jfrabosi/RadarWork/box_mount.SLDPRT

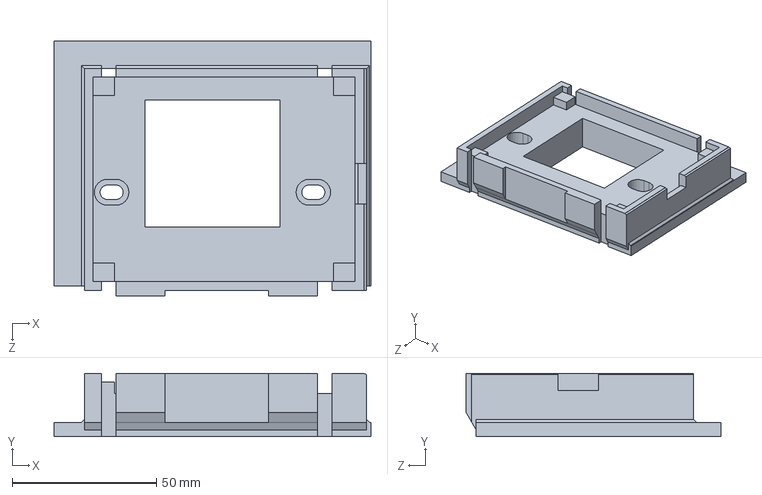
[picture p1: CAD file, 2024-11-15]
box_mount.SLDPRT
110.0 x 22.0 x 88.5 mm
