jfrabosi/RadarWork/QTY1_radar_mount_B.STL

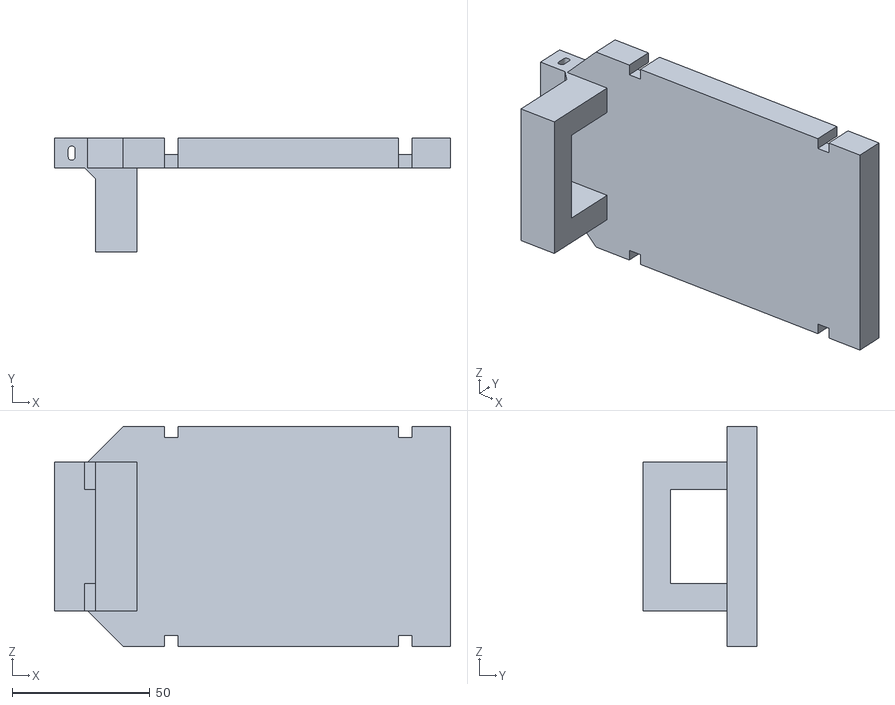
[picture p2: CAD file, 2024-10-24]
QTY1_radar_mount_B.STL
144.0 x 41.5 x 80.0
