jfrabosi/RadarWork/stick_mount.SLDPRT

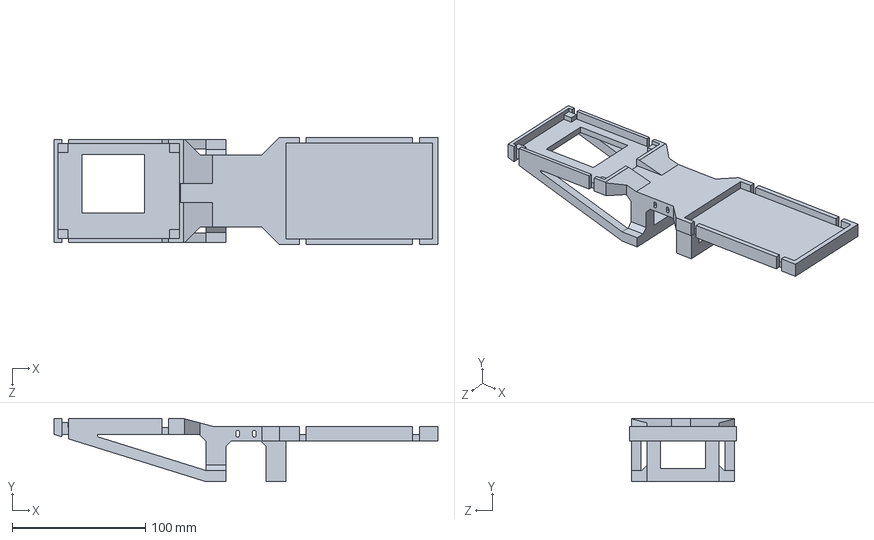
[picture p3: CAD file, 2024-10-24]
stick_mount.SLDPRT
288.0 x 47.5 x 80.0 mm
