jfrabosi/RadarWork/QTY1_radar_mount_A.STL

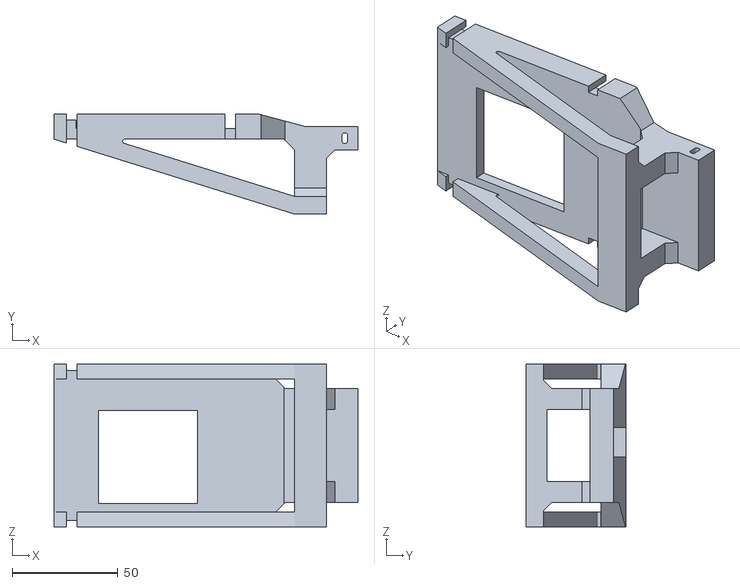
[picture p4: CAD file, 2024-10-24]
QTY1_radar_mount_A.STL
144.0 x 47.5 x 77.0
