jfrabosi/RadarWork/testing_pics/Bathtub/tub_draining.png

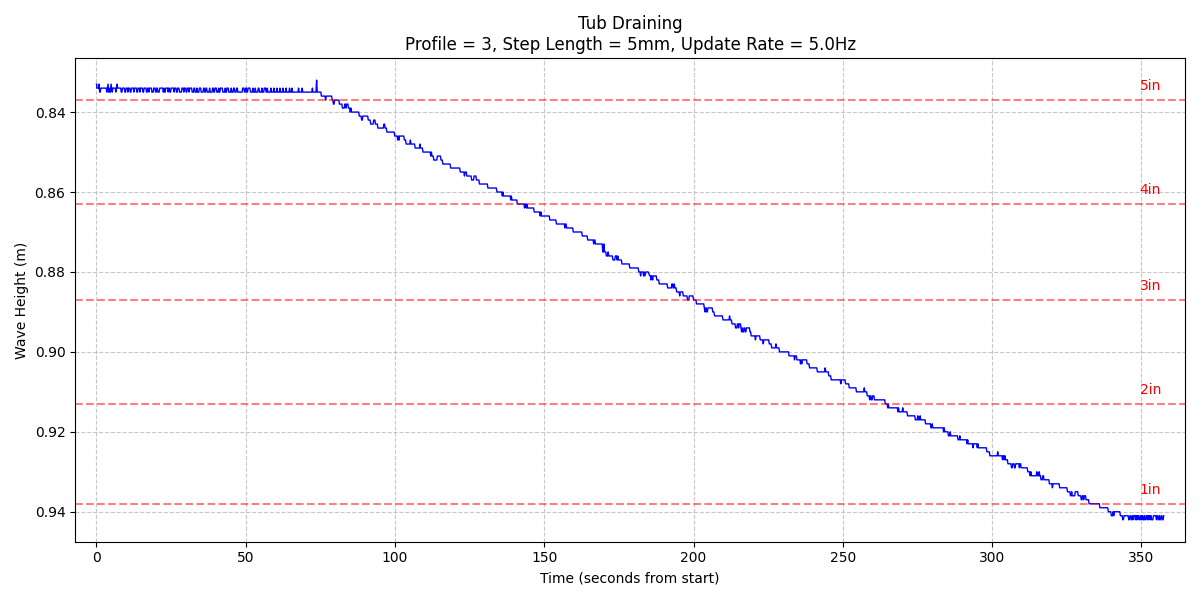
testing_pics/Bathtub/tub_draining.png
