jfrabosi/RadarWork/testing_pics/Bathtub/tub_filling.png

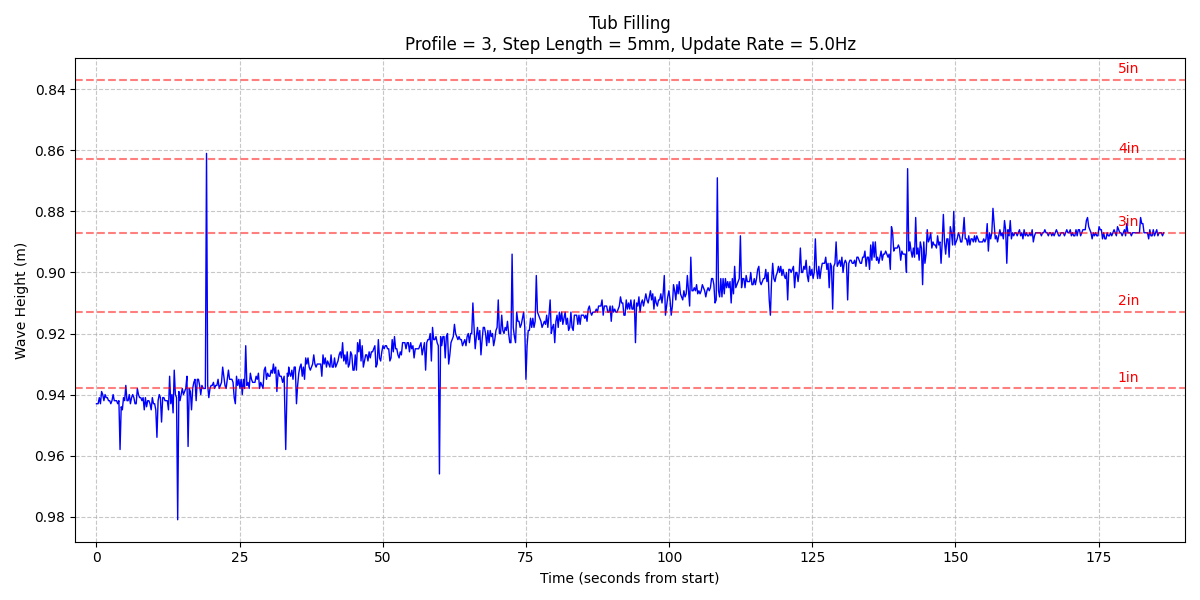
testing_pics/Bathtub/tub_filling.png
