jfrabosi/RadarWork/testing_pics/Fo-SHIP/20hz.png

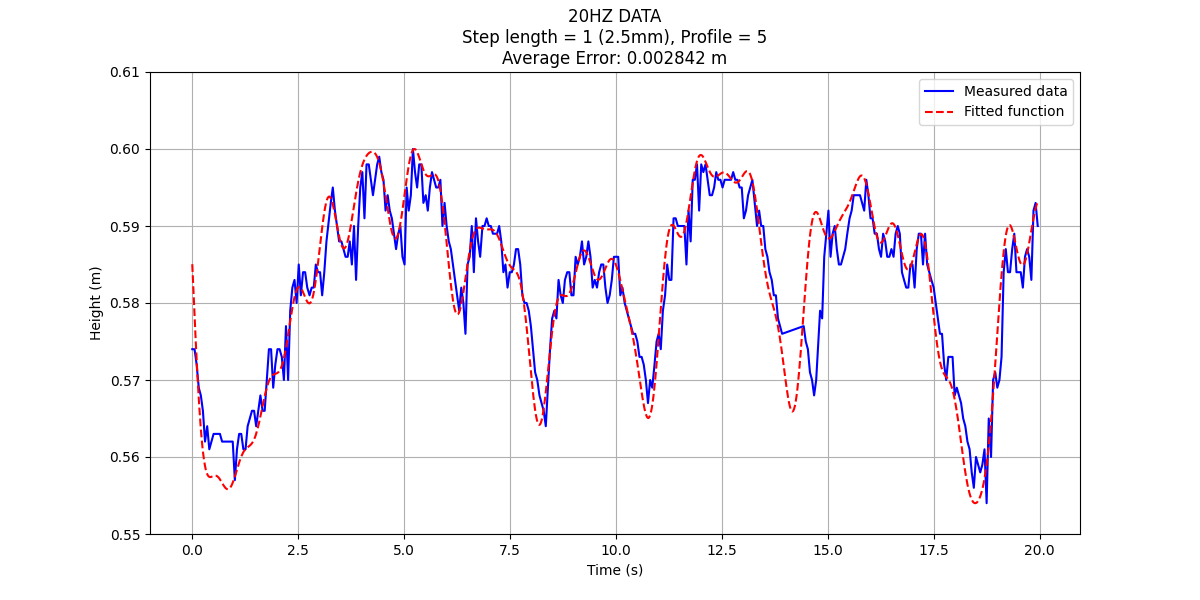
testing_pics/Fo-SHIP/20hz.png
