jfrabosi/RadarWork/testing_pics/Fo-SHIP/l1p1.png

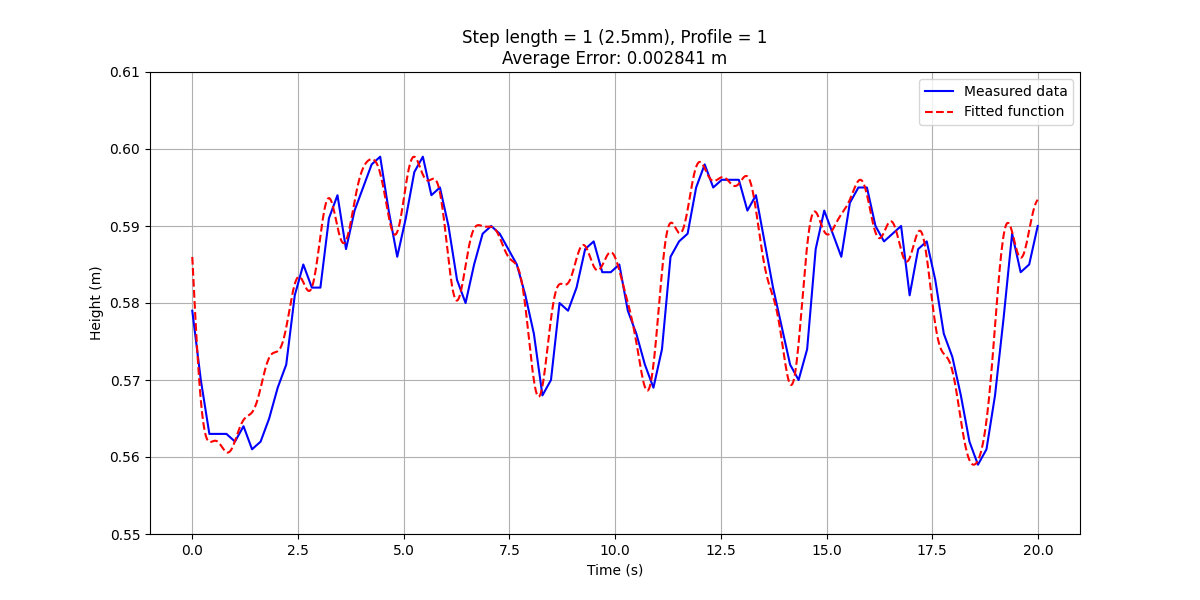
testing_pics/Fo-SHIP/l1p1.png
