jfrabosi/RadarWork/testing_pics/Fo-SHIP/l1p2.png

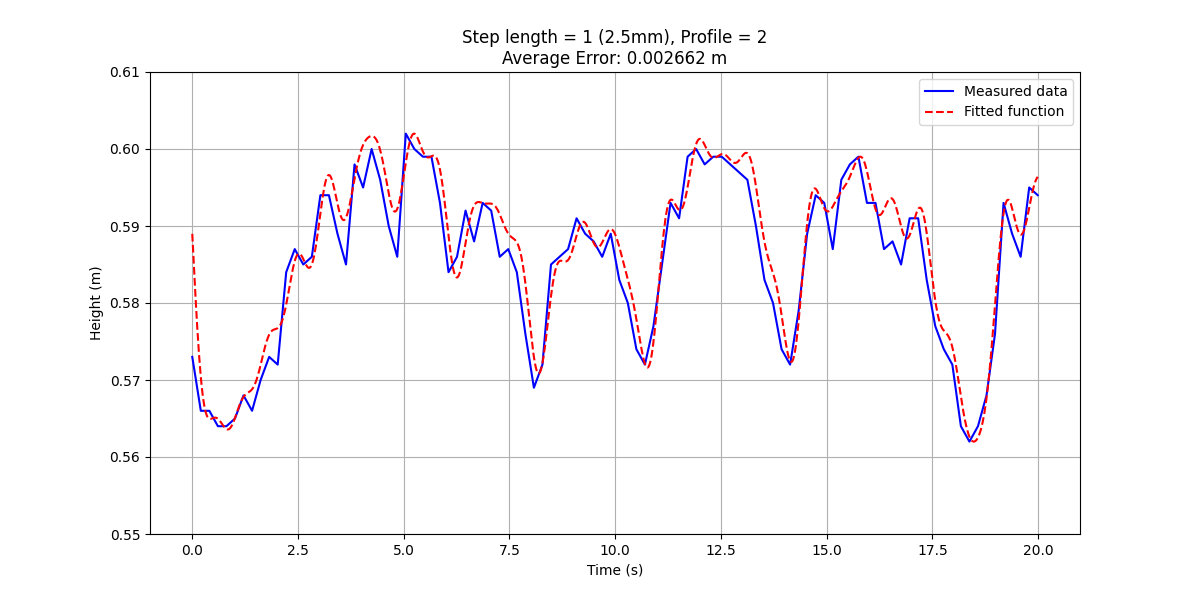
testing_pics/Fo-SHIP/l1p2.png
