jfrabosi/RadarWork/testing_pics/mbari_first_look.png

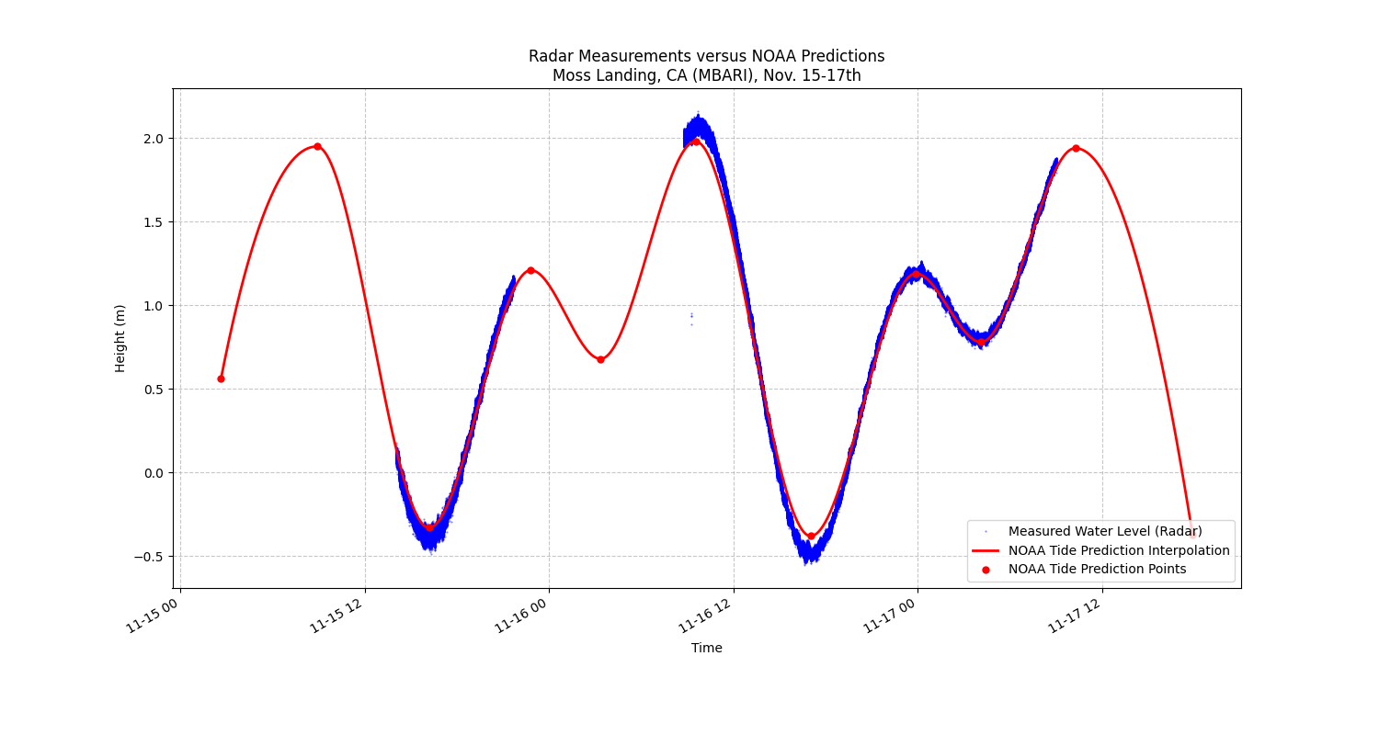
testing_pics/mbari_first_look.png
