jfrabosi/RadarWork/testing_pics/mbari_first_look_closeup.png

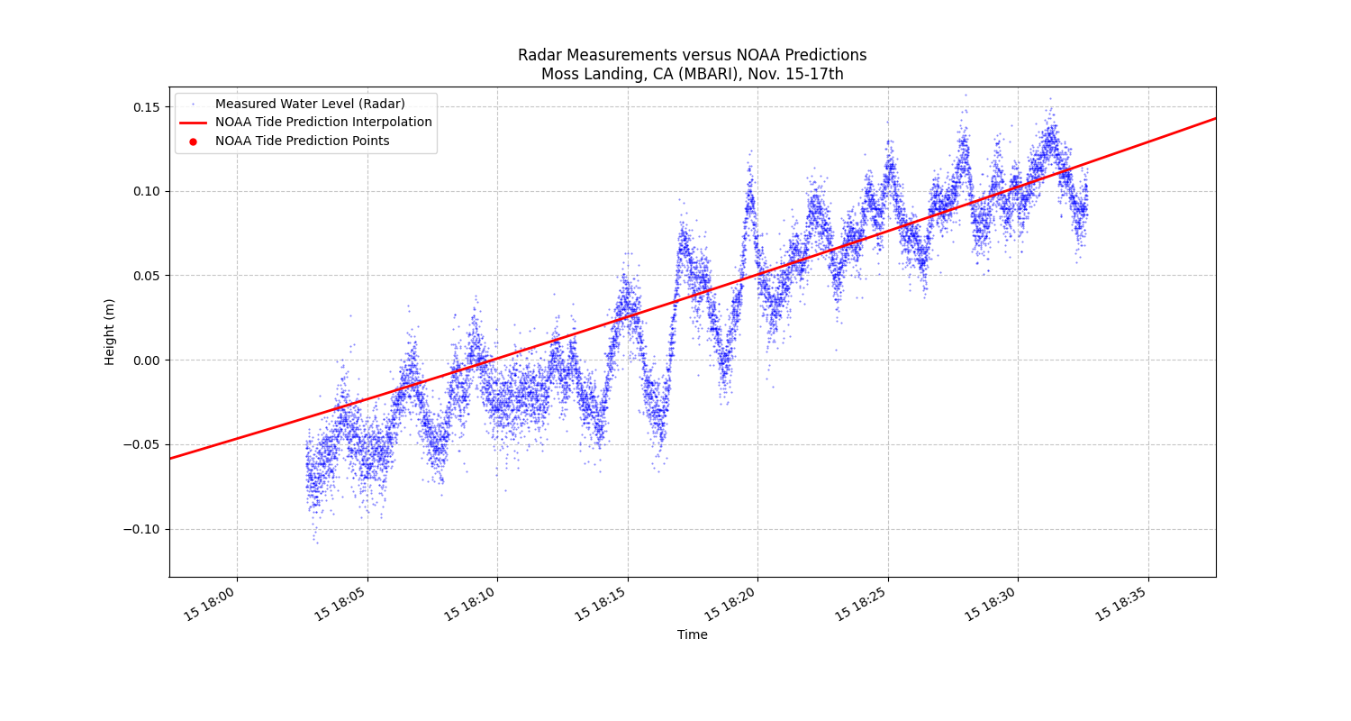
testing_pics/mbari_first_look_closeup.png
