jfrabosi/RadarWork/testing_pics/mbari_vs_noaa_monterey.png

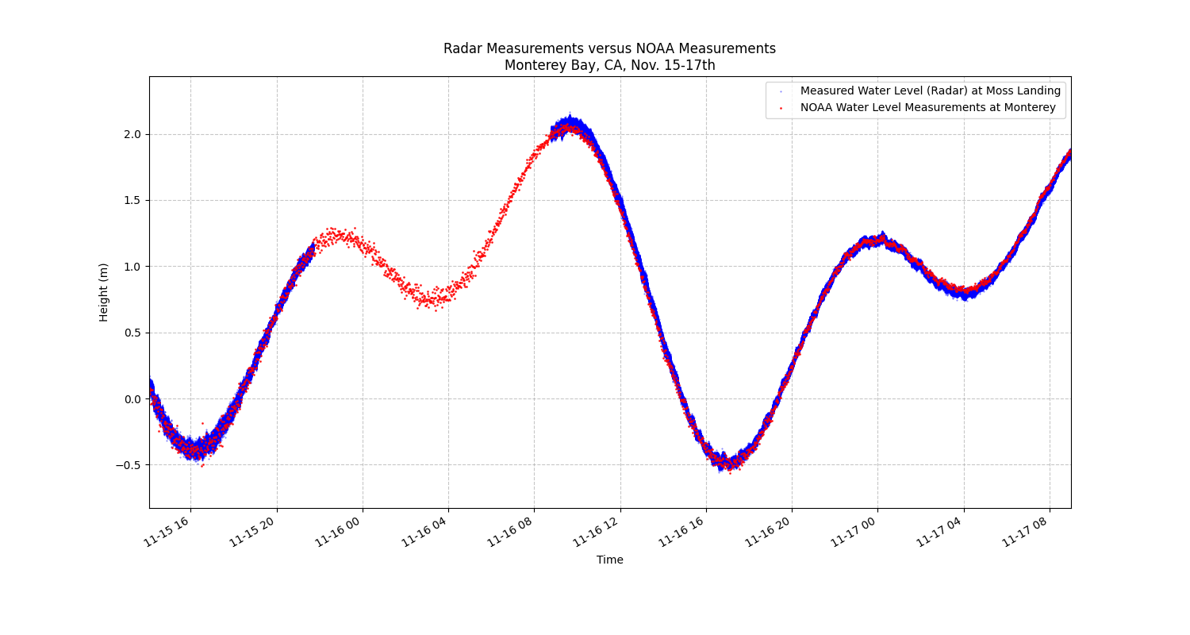
testing_pics/mbari_vs_noaa_monterey.png
