jfrabosi/RadarWork/testing_pics/mbyc/l4u10_compared_60.png

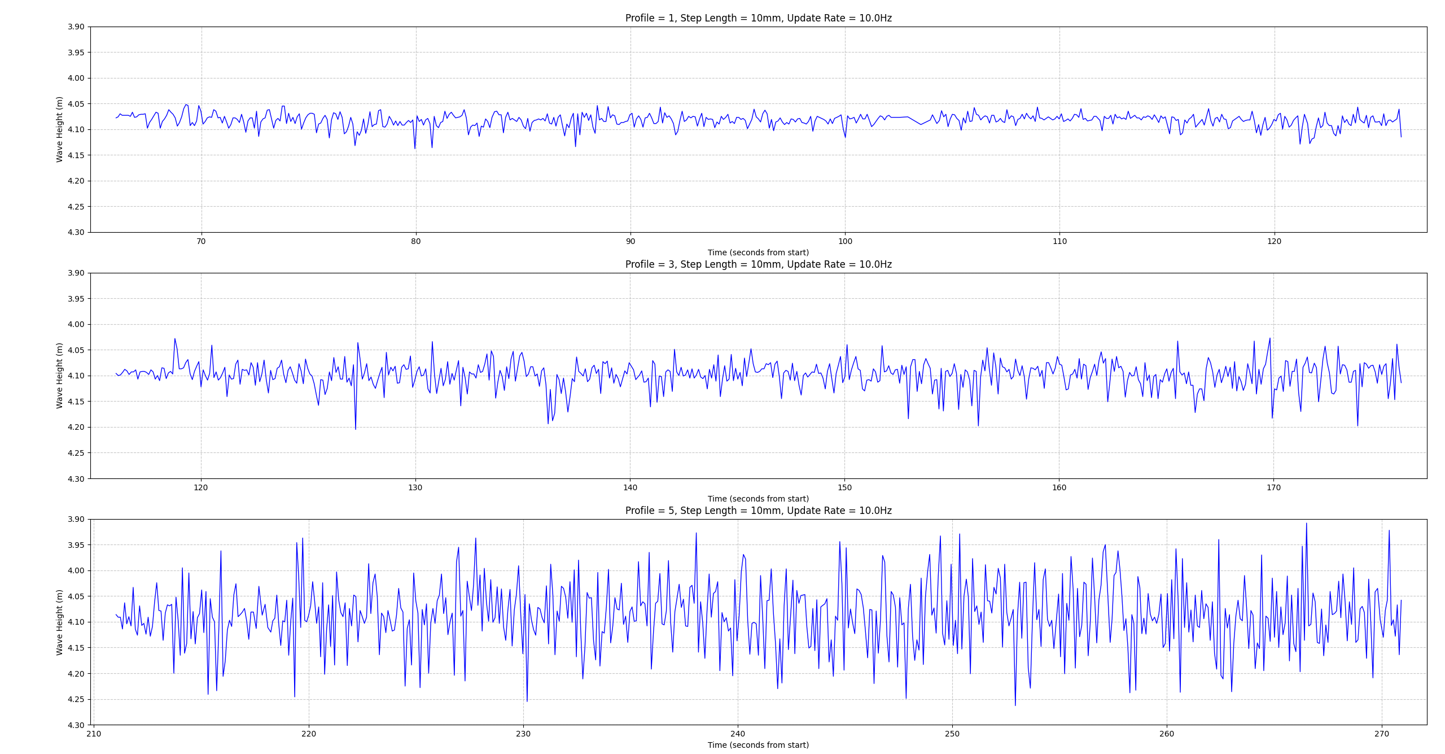
testing_pics/mbyc/l4u10_compared_60.png
