jfrabosi/RadarWork/testing_pics/mbyc/p1l4u10_60.png

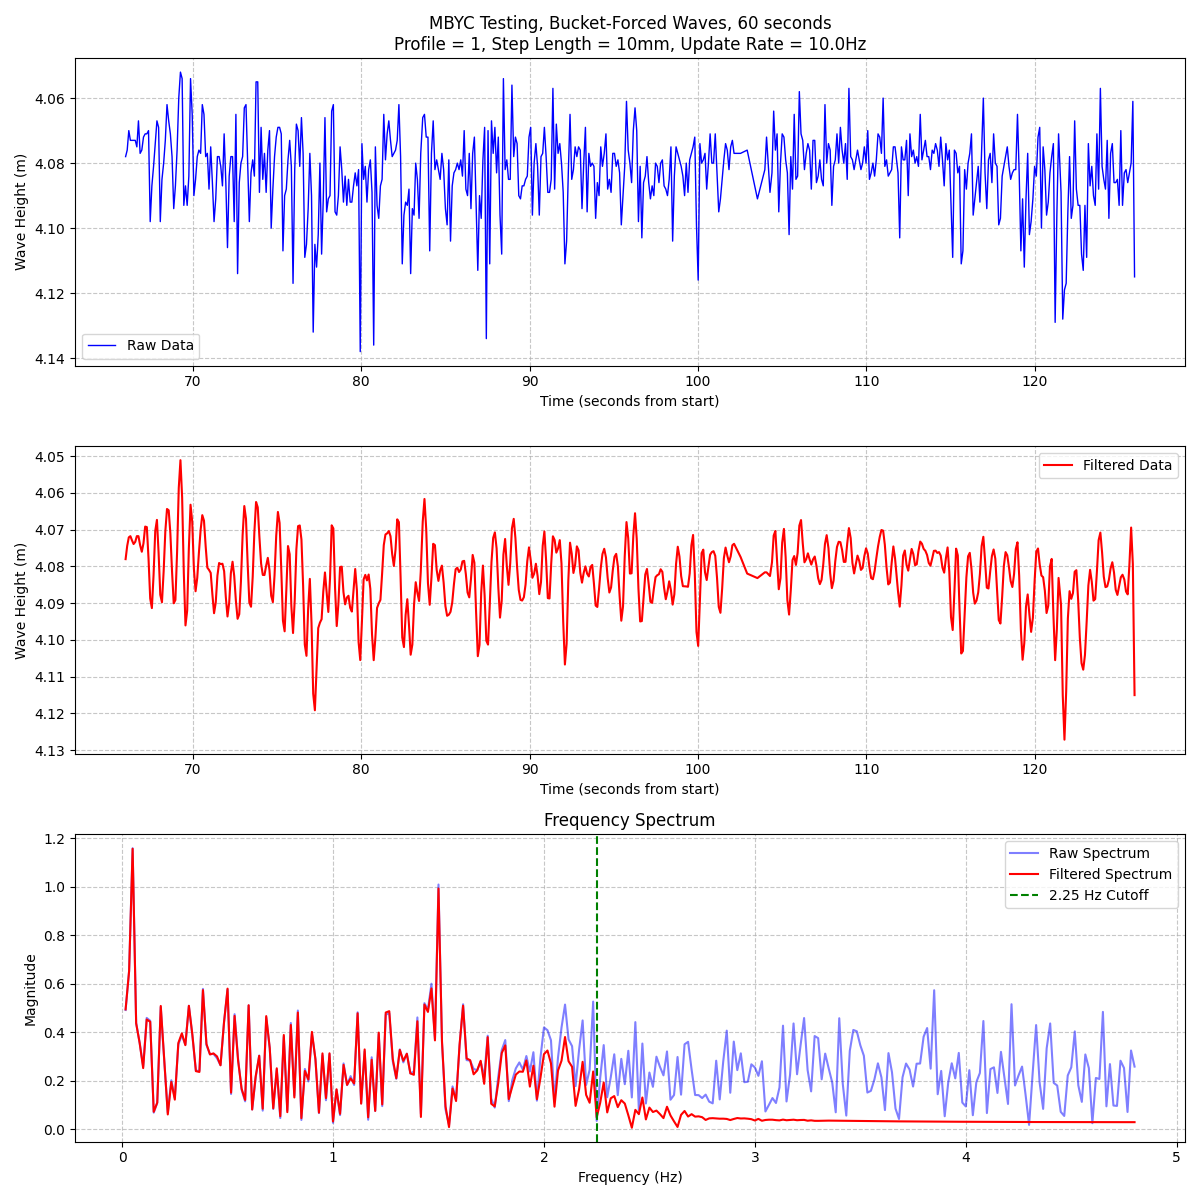
testing_pics/mbyc/p1l4u10_60.png
