jfrabosi/RadarWork/testing_pics/mbyc/p1l6u5_20.png

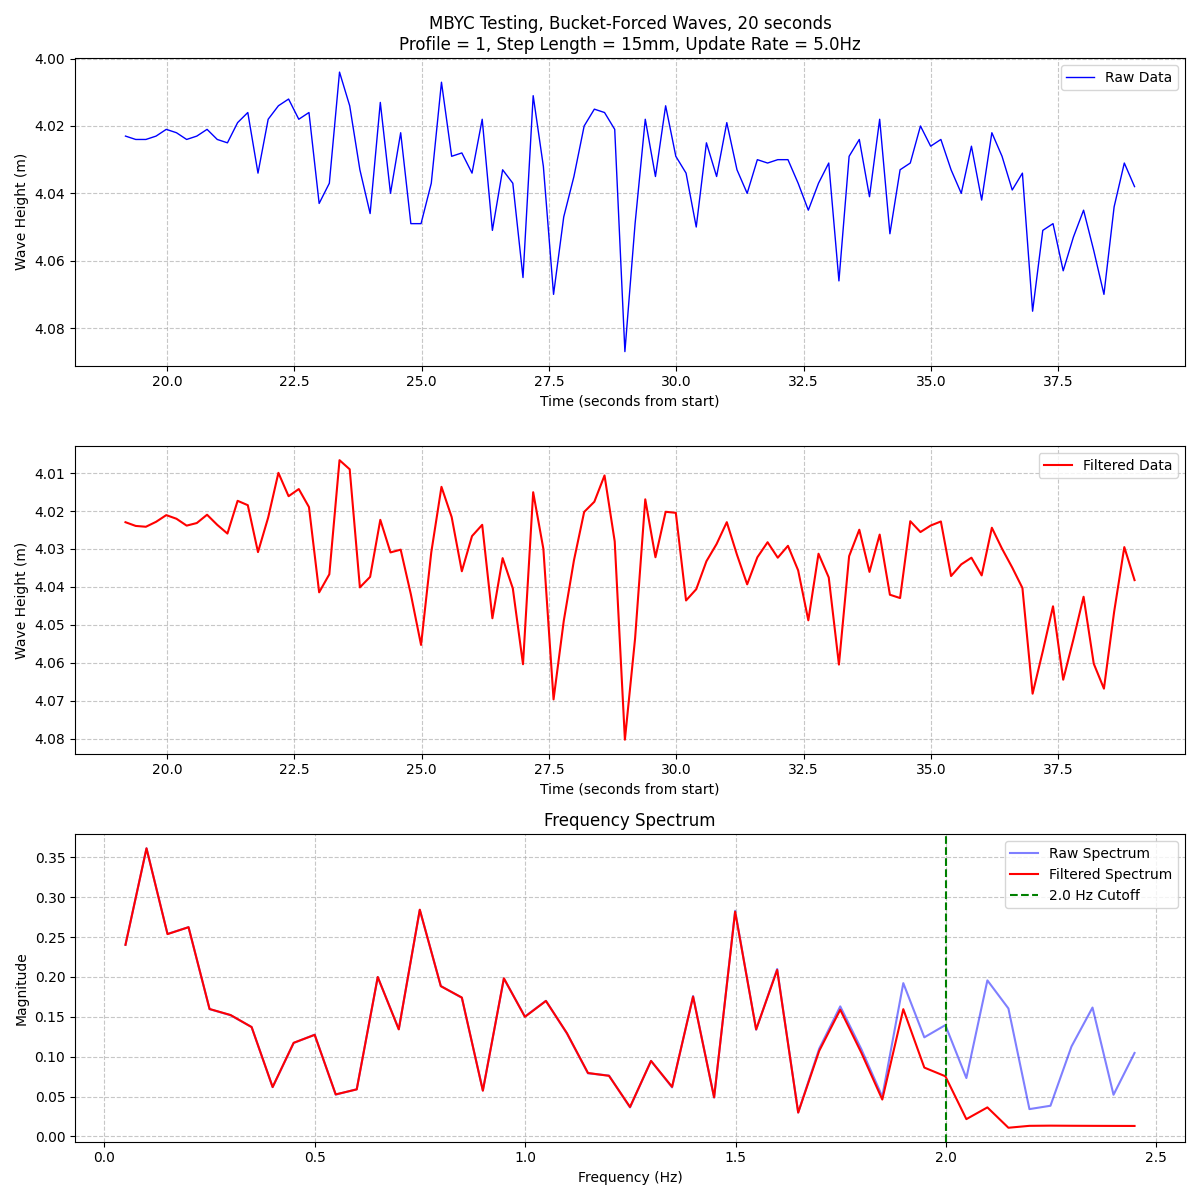
testing_pics/mbyc/p1l6u5_20.png
