jfrabosi/RadarWork/testing_pics/mbyc/p5l4u10_60.png

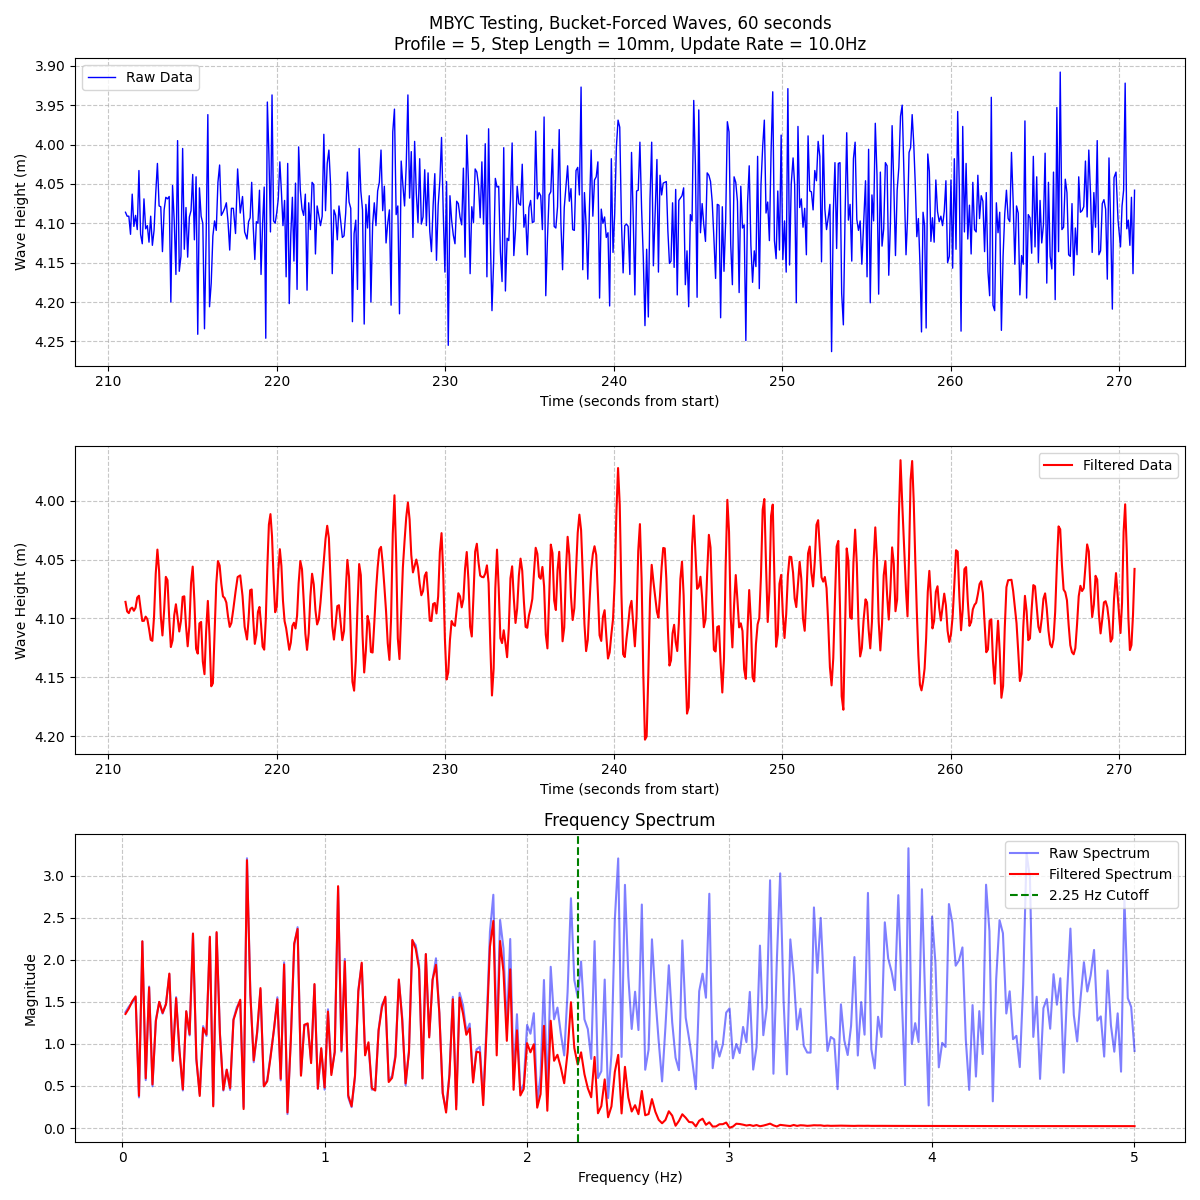
testing_pics/mbyc/p5l4u10_60.png
