jfrabosi/RadarWork/sd_backup/DEBUG_LOGS/24-12-03_17-08-56_debug.txt

BT Received: meow!!
BT Received: woof oooff bark barj
BT Received: beark byark byark /n
BT Received: slow
BT Received: meowoow
