jfrabosi/RadarWork/sd_backup/DEBUG_LOGS/24-12-03_17-13-36_debug.txt

BT Received: hggggg
BT Received: ssddfgjuiuhhhh!!!
