jfrabosi/RadarWork/xm125/xm125.ioc

Mcu.UserName=STM32L431CBYx
PA0.GPIO_Label=UART_CTS
PA0.Signal=USART2_CTS
PA1.GPIO_Label=UART_RTS
PA1.Signal=USART2_RTS
PA10.GPIO_Label=DEBUG_UART_RX
PA10.Signal=USART1_RX
PA11.GPIO_Label=WAKE_UP
PA11.Signal=GPXTI11
PA2.GPIO_Label=UART_TX
PA2.Signal=USART2_TX
PA3.GPIO_Label=UART_RX
PA3.Signal=USART2_RX
PA4.GPIO_Label=MISC_GPIO1
PA4.Signal=GPIO_Output
PA5.GPIO_Label=SPI_SCK
PA5.Signal=SPI1_SCK
PA6.GPIO_Label=SPI_MISO
PA6.Signal=SPI1_MISO
PA7.GPIO_Label=SPI_MOSI
PA7.Signal=SPI1_MOSI
PA9.GPIO_Label=DEBUG_UART_TX
PA9.Signal=USART1_TX
PB0.GPIO_Label=SPI_SS
PB0.Signal=GPIO_Output
PB1.GPIO_Label=MISC_GPIO0
PB1.Signal=GPIO_Input
PB10.GPIO_Label=I2C_SCL
PB10.Signal=I2C2_SCL
PB11.GPIO_Label=I2C_SDA
PB11.Signal=I2C2_SDA
PB12.GPIO_Label=ENABLE
PB12.Signal=GPIO_Output
PB9.GPIO_Label=MCU_INT
PB9.Signal=GPIO_Output
PH3-BOOT0.GPIO_Label=MISC_GPIO2
PH3-BOOT0.Signal=GPIO_Input
