jfrabosi/RadarWork/(commit log)

2024-09-25 moved CLI code to ESP32
2024-10-24 uploaded test data and SLDWKS
    [QTY1_radar_mount_A.STL, QTY1_radar_mount_B.STL, stick_mount.SLDPRT]
2024-12-13 added radarmanager and low-power mode
    [radar_config.txt]
2024-12-17 fixed low power implementation
    [BluetoothManager.cpp, GPSManager.cpp, RadarManager.cpp, SDCardManager.cpp, TimeManager.cpp]
